thakur-sachin/walking_trex_project/docs/ABLATION_STUDY.md

# Ablation study

Every training run of the Trex walking task: what it changed, why, what was measured and what was learned.
Generated by `walk_rl/ablation_study.py` from `walk_rl/experiments/registry.yaml` and `outputs/walk_runs/` (2026-10-24 10:53). Do not edit by hand.

**How to read it.** Each run makes one change against its parent. Results are only comparable within one robot model: the simulator's robot changed six times as measurements came in. A value marked † was measured on a later model than the run trained on (the file was re-run after a model change). Each run is judged on the servo model it trained with: `ideal` is the PD drive of M0/M1, `lx16a` the fitted LX-16A model. Isaac numbers are walking at 0.10 m/s with randomization on; MuJoCo numbers are the deployed NumPy loop over friction × bus delay (median speed). "MuJoCo own model" is the same sweep with the robot rebuilt from the robot_config the run trained with, so every run is scored on its own robot; it shows transfer to a second engine, not a ranking across models. Old run configs: `git show <config>`.

## Robot models

| model | from | change | detail |
|---|---|---|---|
| M0 | 2026-10-09 00:00 | URDF model, ideal servo | torso inertia from the URDF (a steel shell), PD position drive at datasheet speed, CAD masses (1.78 kg) |
| M1 | 2026-10-15 20:55 | corrected torso and ankle | composite torso inertia (~5x below the URDF), ankle torque routed through the linkage |
| M2 | 2026-10-18 17:19 | + LX-16A servo model (unloaded fit) | explicit torque model fitted to single-servo moves in the air; ~4x slower than M0's servo |
| M3 | 2026-10-19 15:22 | + as-built joint ranges, mass estimates | hips -30..+7 deg, tibia -45..+90 deg, coupled ankle limit; 1.50 kg |
| M4 | 2026-10-19 21:54 | + measured masses | whole robot 1.307 kg weighed; torso inertia from its parts |
| M5 | 2026-10-20 22:44 | + servo model refit to real walks | kp, friction, speed and stall refit by replaying the real v9m walks in MuJoCo |
| M6 | 2026-10-21 22:50 | + measured centre of mass | battery and electronics moved 25 mm back so the whole-robot CoM sits 30 mm ahead of the heel edge (measured balance point; was 40.8 mm) |
| M7 | 2026-10-23 21:40 | + joint limits v2 | joint stops measured by hand: head -45..+35, tail +-45, hips -45..+7, femurs +-50, tibias -35..+75 deg (v1: +-45, hips -30..+7, tibias -45..+90) |

## Runs

| run | parent | model | servo | change | Isaac speed @0.10 | Isaac hard surv. | MuJoCo survived | MuJoCo speed @0.10 | MuJoCo own model: survived | own model: speed @0.10 | scorecard | real robot | verdict |
|---|---|---|---|---|---|---|---|---|---|---|---|---|---|
| **v1** |  | M0 | ideal | first walking task; adaptive learning rate | — | — | — | — | — | — | — | — | rejected |
| **v2** | v1 | M0 | ideal | + yaw tracking, action_accel -0.5 | — | — | — | — | — | — | — | — | rejected |
| **v3** | v2 | M0 | ideal | command low-pass, action_accel -0.05, LR 1e-3 | — | — | — | — | — | — | — | — | rejected |
| **v4** | v3 | M0 | ideal | KL guard, best checkpoints, from scratch | — | — | — | — | — | — | — | — | rejected |
| **v6** | v4 | M0 | ideal | any non-foot ground contact ends the episode; contact from forces | — | — | — | — | — | — | — | — | rejected |
| **v7** | v6 | M0 | ideal | training-only harness (70 % body weight + righting torque, gone by iteration 450); stale-contact fix | 90% | 0.35 | — | — | 25/36 | 54% | — | — | base |
| **v8c** | v7 | M0 | ideal | heading observation, 3-frame history, delays, encoder offsets, pushes, new rewards | 97% | 0.88 | — | — | 33/36 | 61% | — | — | superseded |
| **v8b** | v8c | M0 | ideal | v8c without pushes | 101% | 0.95 | — | — | 13/36 | 56% | — | — | rejected |
| **v8d** | v8c | M0 | ideal | gait clock frequency scales with speed | 90% | 0.91 | 50/54 | 68% | 33/36 | 62% | — | — | base |
| **v8e** | v8d | M0 | ideal | 16384 envs, 3000 iterations, pushes to 0.35 m/s | 94% | 0.98 | — | — | 32/36 | 77% | — | — | superseded |
| **v8e_lab** | v8e | M0 | ideal | the same config on the Isaac Lab port | 90% | 0.98 | — | — | 23/36 | 36% | — | — | superseded |
| **v8e_lab_rsl** | v8e | M0 | ideal | rsl_rl PPO instead of the in-repo PPO | — | — | — | — | — | — | — | — | aborted |
| **v9p** | v8e | M1 | ideal | corrected robot model, torso-inertia and wood-friction randomization, std cap 0.5 | 106% | 0.98 | 24/27 | 66% | 31/36 | 66% | — | — | superseded |
| **v9a** | v9p | M1 | ideal | + lateral_drift, roll_band, foot_flat | 113% | 0.99 | 20/27 | 66% | 23/36 | 66% | — | — | base |
| **v9b** | v9a | M1 | ideal | + mirror augmentation | 128% | 0.82 | 18/27 | 88% | 23/36 | 88% | — | — | rejected |
| **v9c** | v9a | M2 | lx16a | + actuator.model lx16a | 13%† | 0.7† | 32/36† | 0%† | 36/36 | 0% | 3/11 | — | superseded |
| **v9d** | v9c | M2 | lx16a | track_vx sigma relative to the command, both-feet gait contact, slow-command oversampling | 53%† | 0.75† | 32/36† | 15%† | 36/36 | 37% | — | — | superseded |
| **v9e** | v9d | M3 | lx16a | tibia action scale 90 deg | 2% | 0.96 | 34/36 | 0% | 34/36 | 0% | — | — | rejected |
| **v9f** | v9d | M3 | lx16a | tibia +-67.5 deg about +22.5 deg (shifted action centre) | 0% | 0.99 | 36/36 | 0% | 36/36 | 0% | — | — | rejected |
| **v9g** | v9d | M4 | lx16a | none (v9d recipe on the measured robot) | — | — | — | — | 36/36 | 0% | — | — | rejected |
| **v9h** | v9g | M4 | lx16a | reward.progress_gate (posture and smoothness rewards scale with v_x / cmd) | 129% | 0.95 | 21/36 | 56% | 21/36 | 56% | — | — | superseded |
| **v9i** | v9h | M4 | lx16a | progress_gate_mode tracking (gate peaks at the command) | 86% | 0.95 | 32/36 | 59% | 32/36 | 59% | 3/11 | — | superseded |
| **v9j** | v9i | M4 | lx16a | + leg_symmetry (1 s mean of left - right femur/tibia), weak base_height | 87% | 0.9 | 32/36 | 57% | 32/36 | 57% | 5/11 | — | superseded |
| **v9k** | v9j | M4 | lx16a | + joint_pose on head and tail | 84% | 0.92 | 33/36 | 43% | 33/36 | 43% | 5/11 | — | superseded |
| **v9l** | v9k | M4 | lx16a | foot_slip at the sole centre, weight -100 | 0% | 0.86 | 34/36 | 0% | 34/36 | 0% | 1/11 | — | rejected |
| **v9m** | v9k | M4 | lx16a | foot_slip at the sole centre, weight -10 | 88% | 0.96 | 29/36† | 52%† | 33/36 | 59% | 7/11 | 2026-10-20 floor, 0.10 m/s for 10 s: 0.41 m (41 %), no fall, yaw +7 deg | deployed |
| **v9n** | v9m | M5 | lx16a | servo model refit to the real walks (randomization re-centred) + IMU mount offset +-2 deg | 94% | 0.95 | 33/36 | 72% | 33/36 | 72% | 6/11 | 2026-10-21 floor, 0.10 m/s for 10 s: 0.25 m (25 %), turned +49 deg; head -14, tail +18, hips +3 / -9 deg mean | deployed |
| **v9o** | v9n | M5 | lx16a | + mirror loss 0.5 (soft left/right symmetry) | 91% | 0.97 | 35/36 | 70% | 35/36 | 70% | 6/11 | 2026-10-21 floor, 0.10 m/s for 10 s: 0.46 m (46 %), yaw -8 deg, slight drift right, no crab; head -1, tail -2, hips -7 / -3 deg mean | deployed |
| **v9q** | v9o | M6 | lx16a | training friction down to the measured floor (0.12-0.85 effective via ground friction 0.1; was 0.30-0.85) | 89% | 0.91 | 36/36 | 77% | 36/36 | 77% | 6/11 | — | candidate |
| **v9r** | v9o | M6 | lx16a | none (v9o recipe retrained on M6); control run for v9q | 90% | 0.88 | 36/36 | 78% | 36/36 | 78% | 6/11 | — | rejected |
| **v9s** | v9q | M6 | lx16a | + joint-limit penalty over the last 3 deg of the physical range (reward.joint_limit_range_margin_deg 3) | 90% | 0.78 | 36/36 | 105% | 36/36 | 105% | 8/11 | 2026-10-22 wood floor, 0.10 m/s for 10 s: 0.36 m (36 %), yaw -1 deg net (+6 deg on a first run without video); hips -2 / -2 deg, head +6, tail +3 deg; joint swing 2-3 deg. Carpet, same schedule: > 0.70 m (> 70 %), yaw +54 / +15 deg (two runs), left hip ~2 deg more inward | deployed |
| **v9t** | v9s | M6 | lx16a | swing_clearance reward weight 2 -> 8 (foot lift) | 84% | 0.89 | 36/36 | 100% | 36/36 | 100% | 8/11 | 2026-10-23 wood floor, 0.10 m/s for 10 s: barely moved forward, turned on the spot +78 deg left (log yaw); +37 deg in the first 2 s, while it goes from the standing pose (tibias +45, femurs +10 deg) to the walking crouch (femurs -26, tibias -10 to -13 deg), then +40 deg over 9 s; joint swing 5-7 deg (v9s 2-3), roll -2..+6 deg, no fall. Carpet, same schedule (after two USB-adapter resets, nothing moved): joint swing 8-11 deg, roll -17..+7 deg, yaw +64 deg by the stop; fell 0.7 s after the command went to 0 (head swung to +41 deg, tilt 55 deg forward-left, safety stop). Carpet run 2 (2026-10-23, no fall): ~0.70 m forward and ~0.40 m to the left (0.81 m straight line), yaw about +34 deg net, roll -12..+14 deg, joint swing 7-12 deg. Wood run 2 (2026-10-23): ~0.50 m forward (50 %, the best wood result; v9o 46 %) and ~0.20 m to the right, then it hit a wall on its right; yaw at most -17 deg, +4 deg net; roll +2..+8 deg; joint swing 4-8 deg; no fall. Wood runs 3-5 (2026-10-23): turned > 100 deg left at some point in every run (+88 / +74 / +65 deg net), distances not measured | rejected |
| **v9u** | v9s | M7 | lx16a | none (v9s recipe retrained on M7, joint limits v2) | — | — | — | — | — | — | — | — | aborted |
| **v9v** | v9s | M7 | lx16a | actions.scale_to_range (action mapped onto the physical range of joint limits v2, no range clip) | 88% | 0.82 | 36/36 | 86% | 36/36 | 86% | 8/11 | — | candidate |
| **v9w** | v9v | M7 | lx16a | reward joint_speed -2.0 = relu(weighted mean |joint vel| - 0.7 rad/s), tail weight 2 | 76% | 0.81 | 36/36 | 71% | — | — | 8/11 | — | candidate (sim speed target missed) |

## Run details

### v1 · M0 · rejected

- **Change:** first walking task; adaptive learning rate
- **Why:** baseline of the new task
- **Result:** circled 100-116 deg per 20 s and chattered while standing; later found to lean on its tail
- **Lesson:** an adaptive (rsl_rl-style) LR pins at its floor when the action std is small
- **Training:** 404 iterations, 4096 envs, 30 min, final action std 0.13

### v2 ← v1 · M0 · rejected

- **Change:** + yaw tracking, action_accel -0.5
- **Why:** stop the circling and the chatter
- **Result:** never learned; the penalty charged ~-3 per step for exploration noise
- **Lesson:** smoothness penalties on sampled actions punish exploration; use a command low-pass instead

### v3 ← v2 · M0 · rejected

- **Change:** command low-pass, action_accel -0.05, LR 1e-3
- **Why:** structural smoothing instead of a heavy penalty
- **Result:** best curve to iteration ~750, then collapsed in one update (KL 0.24 at std 0.13); best weights lost
- **Lesson:** keep a per-minibatch KL guard, best.pt and periodic checkpoints
- **Training:** 800 iterations, 4096 envs, 79 min, final action std 0.13

### v4 ← v3 · M0 · rejected

- **Change:** KL guard, best checkpoints, from scratch
- **Why:** v3's recipe without the collapse
- **Result:** 100 % survival and ~97 % tracking, but it walked on a tripod (tail on the ground); 0 % survival once that is a fall
- **Lesson:** make every implied rule an explicit termination; look at the frames before believing a metric
- **Training:** 900 iterations, 4096 envs, 74 min, final action std 0.14

### v6 ← v4 · M0 · rejected

- **Change:** any non-foot ground contact ends the episode; contact from forces
- **Why:** only the feet may touch the ground
- **Result:** stood still (foot air time 0.000 at iteration 200)
- **Lesson:** lifting a foot unaided is an exploration barrier

### v7 ← v6 · M0 · base

- **Change:** training-only harness (70 % body weight + righting torque, gone by iteration 450); stale-contact fix
- **Why:** get past the exploration barrier
- **Result:** first valid biped; 99 % survival at 0.10, 97 % tracking; heading drift up to 34 deg per 20 s
- **Lesson:** a curriculum that is removed during training can open a gait that RL does not find alone
- **Training:** 1000 iterations, 4096 envs, 51 min, final action std 0.26

### v8c ← v7 · M0 · superseded

- **Change:** heading observation, 3-frame history, delays, encoder offsets, pushes, new rewards
- **Why:** robustness to the real sensors and drift
- **Result:** heading change 0.7-2.4 deg per 20 s (v7 10-34); hard-sensor survival 88-97 % (v7 35-58 %)
- **Training:** 1000 iterations, 4096 envs, 66 min, final action std 0.28

### v8b ← v8c · M0 · rejected

- **Change:** v8c without pushes
- **Why:** which part of v8 did the work
- **Result:** best speed and hard-sensor survival; push survival 0.88 vs 0.95
- **Lesson:** observations, rewards and sensor delays did the heavy lifting; pushes buy push recovery only
- **Training:** 1000 iterations, 4096 envs, 88 min, final action std 0.26
- **Config:** `git show 1017f24:walk_rl/experiments/v8b_no_robustness.yaml`

### v8d ← v8c · M0 · base

- **Change:** gait clock frequency scales with speed
- **Why:** less sway at speed, less standing jitter
- **Result:** standing jitter halved; speed still capped at ~0.15-0.17 m/s (tibias on their 45 deg limit)
- **Lesson:** when every reward variant hits the same ceiling, check joint limits first
- **Training:** 1000 iterations, 4096 envs, 93 min, final action std 0.28
- **Config:** `git show 1017f24:walk_rl/experiments/v8d_gait_freq.yaml`

### v8e ← v8d · M0 · superseded

- **Change:** 16384 envs, 3000 iterations, pushes to 0.35 m/s
- **Why:** scale
- **Result:** survival 0.98-1.00, but action std ran away to 3.9
- **Lesson:** cap the action std (ppo.max_action_std 0.5)
- **Training:** 3000 iterations, 16384 envs, 523 min, final action std 3.89
- **Config:** `git show ca6f384:walk_rl/experiments/v8e_long_16k.yaml`

### v8e_lab ← v8e · M0 · superseded

- **Change:** the same config on the Isaac Lab port
- **Why:** platform comparison
- **Result:** evaluated on Isaac Sim 0.98-1.00, so training is at parity; std ran away to 34.6
- **Lesson:** same config and seed train different policies on the two stacks; compare statistically
- **Stack:** isaaclab
- **Training:** 3000 iterations, 16384 envs, 513 min, final action std 34.64

### v8e_lab_rsl ← v8e · M0 · aborted

- **Change:** rsl_rl PPO instead of the in-repo PPO
- **Why:** trainer comparison
- **Result:** stopped at iteration 2475 of 3000 when the GPU went to v9; never evaluated
- **Stack:** isaaclab + rsl_rl
- **Training:** 2475 iterations, 16384 envs, 453 min, final action std 0

### v9p ← v8e · M1 · superseded

- **Change:** corrected robot model, torso-inertia and wood-friction randomization, std cap 0.5
- **Why:** physics baseline for every v9 ablation
- **Result:** hard survival 0.98; sideways drift 1.13 m per 20 s at 0.20
- **Training:** 1500 iterations, 4096 envs, 80 min, final action std 0.32
- **Config:** `git show 0047918:walk_rl/experiments/v9p_physics.yaml`

### v9a ← v9p · M1 · base

- **Change:** + lateral_drift, roll_band, foot_flat
- **Why:** v8d crabs ~1 m per 20 s to +y
- **Result:** drift 0.26 m per 20 s (v9p 1.13), roll 15 deg; MuJoCo 7 falls of 27
- **Training:** 1500 iterations, 4096 envs, 81 min, final action std 0.31
- **Config:** `git show 7fbf07e:walk_rl/experiments/v9a_lateral.yaml`

### v9b ← v9a · M1 · rejected

- **Change:** + mirror augmentation
- **Why:** the limp behind the crab is learned (CAD symmetric to 3 mm)
- **Result:** even gait, drift 0.17 m, but hard survival 0.82 and 8 deg yaw while standing
- **Lesson:** hard mirror augmentation costs robustness
- **Training:** 1500 iterations, 4096 envs, 80 min, final action std 0.35
- **Config:** `git show 0047918:walk_rl/experiments/v9b_symmetry.yaml`

### v9c ← v9a · M2 · superseded

- **Change:** + actuator.model lx16a
- **Why:** no earlier policy walks on the fitted servo (walking survival 0.02-0.46)
- **Result:** walking survival 0.99-1.00 on the fitted servo, MuJoCo 27/27; stands below ~0.12 m/s
- **Lesson:** measure the hardware early; the 4x slower servo invalidated every earlier policy
- **Training:** 1500 iterations, 4096 envs, 83 min, final action std 0.26
- **Scorecard:** 3/11; fails: MuJoCo survival, MuJoCo speed @0.10, Isaac speed 0.05-0.15, worst joint at limit, foot lift min @0.10, side / forward @0.10, Isaac saturation max, Isaac hard survival min
- **Config:** `git show 4520314:walk_rl/experiments/v9c_actuator.yaml`

### v9d ← v9c · M2 · superseded

- **Change:** track_vx sigma relative to the command, both-feet gait contact, slow-command oversampling
- **Why:** standing earned ~50 % of track_vx at 0.05 m/s
- **Result:** 99 % of 0.10 in Isaac, MuJoCo 36/36; still stands below ~0.08
- **Lesson:** a fixed tracking kernel lets standing win at slow commands
- **Training:** 1500 iterations, 4096 envs, 90 min, final action std 0.24
- **Config:** `git show d05b2e2:walk_rl/experiments/v9d_slow_gait.yaml`

### v9e ← v9d · M3 · rejected

- **Change:** tibia action scale 90 deg
- **Why:** reach the forward-knee range
- **Result:** walks only from 0.15 m/s; push survival 0.69 (v9d 0.84)
- **Lesson:** a wider action scale doubles exploration noise and halves resolution
- **Training:** 1500 iterations, 4096 envs, 83 min, final action std 0.39
- **Config:** `git show 8c2e1cb:walk_rl/experiments/v9e_knee_range.yaml`

### v9f ← v9d · M3 · rejected

- **Change:** tibia +-67.5 deg about +22.5 deg (shifted action centre)
- **Why:** the knee range without v9e's resolution loss
- **Result:** stands at every command
- **Training:** 1500 iterations, 4096 envs, 85 min, final action std 0.37
- **Config:** `git show b69185e:walk_rl/experiments/v9f_knee_shift.yaml`

### v9g ← v9d · M4 · rejected

- **Change:** none (v9d recipe on the measured robot)
- **Why:** control for v9f
- **Result:** drifted to standing once pushes started (~iteration 500); stopped at 908
- **Lesson:** the standing trap - heading and yaw rewards pay standing almost as much as walking
- **Training:** 908 iterations, 4096 envs, 58 min, final action std 0.26
- **Config:** `git show af2091b:walk_rl/experiments/v9g_control.yaml`

### v9h ← v9g · M4 · superseded

- **Change:** reward.progress_gate (posture and smoothness rewards scale with v_x / cmd)
- **Why:** break the standing trap
- **Result:** walks again, but at 0.10-0.16 m/s whatever the command; MuJoCo 21/36
- **Training:** 1500 iterations, 4096 envs, 82 min, final action std 0.24
- **Config:** `git show fde54b2:walk_rl/experiments/v9h_progress_gate.yaml`

### v9i ← v9h · M4 · superseded

- **Change:** progress_gate_mode tracking (gate peaks at the command)
- **Why:** v9h ignored the command
- **Result:** tracks 0.05-0.15 at 85-93 %; MuJoCo 32/36; video worse than v9c/v9d (scoots, left foot steps back)
- **Lesson:** Isaac-only metrics can hide a scoot; add a gait scorecard
- **Training:** 1500 iterations, 4096 envs, 139 min, final action std 0.3
- **Scorecard:** 3/11; fails: MuJoCo survival, MuJoCo speed @0.10, femur / tibia L-R, worst joint at limit, foot lift min @0.10, side / forward @0.10, Isaac step L/R @0.10,0.15, Isaac saturation max
- **Config:** `git show 7e2670e:walk_rl/experiments/v9i_tracking_gate.yaml`

### v9j ← v9i · M4 · superseded

- **Change:** + leg_symmetry (1 s mean of left - right femur/tibia), weak base_height
- **Why:** tibias 61 deg apart in v9i
- **Targets:** femur / tibia L-R <= 10 deg
- **Result:** legs symmetric (-1 / +4 deg), drift 9 % of forward distance (v9i 142 %)
- **Training:** 1500 iterations, 4096 envs, 90 min, final action std 0.21
- **Scorecard:** 5/11; fails: MuJoCo survival, MuJoCo speed @0.10, worst joint at limit, Isaac step L/R @0.10,0.15, Isaac saturation max, Isaac hard survival min
- **Config:** `git show e09617f:walk_rl/experiments/v9j_posture.yaml`

### v9k ← v9j · M4 · superseded

- **Change:** + joint_pose on head and tail
- **Why:** head and tail pinned at a range end move the CoM < 2 mm and caused falls
- **Result:** head/tail near neutral, steps 1.1 / 1.1 cm; MuJoCo speed 43 % of 0.10
- **Training:** 1500 iterations, 4096 envs, 84 min, final action std 0.15
- **Scorecard:** 5/11; fails: MuJoCo survival, MuJoCo speed @0.10, Isaac speed 0.05-0.15, foot lift min @0.10, Isaac saturation max, Isaac hard survival min
- **Config:** `git show 0053568:walk_rl/experiments/v9k_head_tail.yaml`

### v9l ← v9k · M4 · rejected

- **Change:** foot_slip at the sole centre, weight -100
- **Why:** replay showed ~60 % of Isaac progress was the soles skating
- **Result:** learned to stand
- **Lesson:** a penalty as large as half the reward makes standing the optimum; size weights against the per-step reward
- **Training:** 1500 iterations, 4096 envs, 86 min, final action std 0.18
- **Scorecard:** 1/11; fails: MuJoCo survival, MuJoCo speed @0.10, Isaac speed 0.05-0.15, femur / tibia L-R, worst joint at limit, foot lift min @0.10, side / forward @0.10, Isaac step L/R @0.10,0.15, Isaac saturation max, Isaac hard survival min
- **Config:** `git show 5d470ff:walk_rl/experiments/v9l_sole_slip.yaml`

### v9m ← v9k · M4 · deployed

- **Change:** foot_slip at the sole centre, weight -10
- **Why:** same as v9l at a size that keeps walking cheaper than standing
- **Result:** sole slide 140 mm (v9k 541); Isaac 88 % of 0.10, MuJoCo 52-59 %
- **Real robot:** 2026-10-20 floor, 0.10 m/s for 10 s: 0.41 m (41 %), no fall, yaw +7 deg
- **Lesson:** the real robot made 41 % where Isaac said 88 % and MuJoCo 52-59 %
- **Training:** 1500 iterations, 4096 envs, 85 min, final action std 0.14
- **Scorecard:** 7/11; fails: MuJoCo survival, MuJoCo speed @0.10, Isaac step L/R @0.10,0.15, Isaac saturation max
- **Config:** `git show 3a021e3:walk_rl/experiments/v9m_slip10.yaml`

### v9n ← v9m · M5 · deployed

- **Change:** servo model refit to the real walks (randomization re-centred) + IMU mount offset +-2 deg
- **Why:** real servos held their goals within 0.5 deg where both sims gave 2-5 deg; 1-3 deg attitude offsets swung v9m between 0 and 0.08 m/s
- **Targets:** MuJoCo speed >= 70 % of 0.10; speed stable under 1-3 deg IMU offsets
- **Result:** MuJoCo 72 %, stable under IMU offsets; left hip at its range end 55 %, steps 0.4 / 2.7 cm
- **Real robot:** 2026-10-21 floor, 0.10 m/s for 10 s: 0.25 m (25 %), turned +49 deg; head -14, tail +18, hips +3 / -9 deg mean
- **Lesson:** a one-sided posture that only drifts 5 deg in MuJoCo turned 49 deg on the real floor
- **Training:** 1500 iterations, 4096 envs, 86 min, final action std 0.15
- **Scorecard:** 6/11; fails: MuJoCo survival, worst joint at limit, foot lift min @0.10, Isaac step L/R @0.10,0.15, Isaac hard survival min
- **Config:** `git show f20acf4:walk_rl/experiments/v9n_servo_refit.yaml`

### v9o ← v9n · M5 · deployed

- **Change:** + mirror loss 0.5 (soft left/right symmetry)
- **Why:** the real v9n turn came from a learned one-sided posture, also visible in MuJoCo and Isaac
- **Targets:** head/tail mean within +-5 deg; left hip at its end <= 20 %; Isaac steps within 2x; keep MuJoCo >= 70 % and IMU-offset robustness
- **Result:** head/tail -1 / -1 deg, no joint at a range end, MuJoCo heading change -0.2 deg, MuJoCo 70 %; steps 1.6 / 0.8 cm (2.0x); drifts sideways 43 % of forward distance in MuJoCo
- **Real robot:** 2026-10-21 floor, 0.10 m/s for 10 s: 0.46 m (46 %), yaw -8 deg, slight drift right, no crab; head -1, tail -2, hips -7 / -3 deg mean
- **Lesson:** the soft mirror loss removed the real turn and gave the best real speed so far; the MuJoCo sideways drift did not transfer
- **Training:** 1500 iterations, 4096 envs, 88 min, final action std 0.14
- **Scorecard:** 6/11; fails: MuJoCo survival, MuJoCo speed @0.10, foot lift min @0.10, side / forward @0.10, Isaac step L/R @0.10,0.15
- **Config:** `git show 92b3140:walk_rl/experiments/v9o_mirror_loss.yaml`

### v9q ← v9o · M6 · candidate

- **Change:** training friction down to the measured floor (0.12-0.85 effective via ground friction 0.1; was 0.30-0.85)
- **Why:** real wood is static mu 0.27 (tilt test), below the training range; on M6 v9o makes 34 / 67 / 75 % of 0.10 in MuJoCo at mu 0.15 / 0.20 / 0.27
- **Targets:** MuJoCo >= 60 % of 0.10 at mu 0.15, 0.20, 0.27; MuJoCo survival >= 35/36 and no fall at mu 0.15; head/tail mean within +-5 deg, no joint at a range end > 20 %; real floor >= 50 %
- **Result:** MuJoCo 80-91 / 82-91 / 81-84 % of 0.10 at mu 0.15 / 0.20 / 0.27, 36/36 at low mu; head/tail -1 / +5 deg; right hip at its +7 deg inward end 49-51 % while walking (hips -8 / +2 deg); Isaac 46 % at 0.05, hard survival 0.91; side drift 15 %
- **Lesson:** the low-friction training range fixed the MuJoCo low-friction speed, but on M6 the policy rides the hip goal clip; the joint-limit penalty only sees the symmetric +-30 deg limit, not the +7 deg inward range end
- **Training:** 1500 iterations, 4096 envs, 148 min, final action std 0.15
- **Scorecard:** 6/11; fails: Isaac speed 0.05-0.15, worst joint at limit, foot lift min @0.10, Isaac step L/R @0.10,0.15, Isaac hard survival min
- **Config:** `git show 54f8efb:walk_rl/experiments/v9q_low_friction.yaml`

### v9r ← v9o · M6 · rejected

- **Change:** none (v9o recipe retrained on M6); control run for v9q
- **Why:** v9q changes the robot model and the training friction together; v9r isolates the model change
- **Targets:** same as v9q; hypothesis - keeps v9o's weakness at mu 0.15
- **Result:** MuJoCo 68-144 % of 0.10 at mu 0.15-0.27 (overspeed), 36/36; stands with both hips at +6 deg (inward end 100 %), does not walk at 0.05 (1 %, tail +25 deg); roll spread 22 deg; Isaac hard survival 0.88
- **Lesson:** hypothesis false - M6 alone does not keep v9o's low-friction weakness, but the v9o recipe on M6 parks both hips on the inward goal clip and stops walking at 0.05; M6 needs a range-aware limit penalty
- **Training:** 1500 iterations, 4096 envs, 149 min, final action std 0.19
- **Scorecard:** 6/11; fails: Isaac speed 0.05-0.15, worst joint at limit, roll spread @0.10, Isaac step L/R @0.10,0.15, Isaac hard survival min
- **Config:** `git show 147ced1:walk_rl/experiments/v9r_m6_control.yaml`

### v9s ← v9q · M6 · deployed

- **Change:** + joint-limit penalty over the last 3 deg of the physical range (reward.joint_limit_range_margin_deg 3)
- **Why:** on M6 v9q kept its right hip on the +7 deg inward goal clip 49-51 % of the walk and v9r parked both hips there; the symmetric +-30 deg penalty did not see that end
- **Targets:** no joint at a range end > 20 %; hips mean within +-5 deg, left - right within 4 deg; keep MuJoCo >= 60 % of 0.10 at mu 0.15 / 0.20 / 0.27 and survival >= 35/36; Isaac >= 60 % at 0.05; real floor >= 50 %
- **Result:** no joint at a range end (hips <= 3 %), hips -2 / -2 deg, heading change 0 deg in the video; MuJoCo 61-71 / 56-66 / 81-87 % of 0.10 at mu 0.15 / 0.20 / 0.27, 36/36; Isaac 99 / 90 / 82 % at 0.05 / 0.10 / 0.15; head +15 deg while standing (+6 walking); Isaac hard survival 0.78 at 0.25 (0.95 at 0.10); scorecard 8/10
- **Real robot:** 2026-10-22 wood floor, 0.10 m/s for 10 s: 0.36 m (36 %), yaw -1 deg net (+6 deg on a first run without video); hips -2 / -2 deg, head +6, tail +3 deg; joint swing 2-3 deg. Carpet, same schedule: > 0.70 m (> 70 %), yaw +54 / +15 deg (two runs), left hip ~2 deg more inward
- **Lesson:** the best sim scorecard gave a worse real walk than v9o; the hip fix transferred (posture as in MuJoCo), but v9s shuffles - joint swing 2-3 deg and foot lift 5.8 mm (v9o 5-8 deg, 14-16 mm) - so its sim speed relied on contact effects the floor does not give; on carpet the same policy made > 70 %, so the wood loss is foot slip, not the gait command; add a foot-lift target to the scorecard
- **Training:** 1500 iterations, 4096 envs, 85 min, final action std 0.13
- **Scorecard:** 8/11; fails: foot lift min @0.10, Isaac step L/R @0.10,0.15, Isaac hard survival min
- **Config:** `git show 7eb3a57:walk_rl/experiments/v9s_range_limit.yaml`

### v9t ← v9s · M6 · rejected

- **Change:** swing_clearance reward weight 2 -> 8 (foot lift)
- **Why:** v9s shuffled (foot lift 6 mm, joint swing 2-3 deg) and made 36 % on wood but > 70 % on carpet; its clearance reward fell to a quarter of v9o's
- **Targets:** MuJoCo foot lift >= 12 mm each foot; femur and tibia swing >= 4 deg; keep no joint at a range end > 20 %, hips within +-5 deg, MuJoCo >= 60 % of 0.10 at mu 0.15 / 0.20 / 0.27, survival >= 35/36, Isaac >= 60 % at 0.05; real wood >= 50 %
- **Result:** foot lift 39 mm, joint swing hips 8 / femurs 10 / tibias 12 deg std (v9s 2-3) - a stepping gait; MuJoCo 36/36, 100 % of 0.10 (home model 119 / 91 / 59 % at 0.05 / 0.10 / 0.20), 58-65 / 55-72 / 58-77 % of 0.10 at mu 0.15 / 0.20 / 0.27 (target 60: two of nine conditions miss); hips -6 / -6 deg (target +-5: miss); tibias at the -45 deg end 17 % median, 33 % worst episode; roll spread 19 deg (v9s 5); Isaac 95 / 84 / 70 % at 0.05 / 0.10 / 0.15, hard survival 0.89; head -22 to -35 deg while walking; scorecard 8/11
- **Real robot:** 2026-10-23 wood floor, 0.10 m/s for 10 s: barely moved forward, turned on the spot +78 deg left (log yaw); +37 deg in the first 2 s, while it goes from the standing pose (tibias +45, femurs +10 deg) to the walking crouch (femurs -26, tibias -10 to -13 deg), then +40 deg over 9 s; joint swing 5-7 deg (v9s 2-3), roll -2..+6 deg, no fall. Carpet, same schedule (after two USB-adapter resets, nothing moved): joint swing 8-11 deg, roll -17..+7 deg, yaw +64 deg by the stop; fell 0.7 s after the command went to 0 (head swung to +41 deg, tilt 55 deg forward-left, safety stop). Carpet run 2 (2026-10-23, no fall): ~0.70 m forward and ~0.40 m to the left (0.81 m straight line), yaw about +34 deg net, roll -12..+14 deg, joint swing 7-12 deg. Wood run 2 (2026-10-23): ~0.50 m forward (50 %, the best wood result; v9o 46 %) and ~0.20 m to the right, then it hit a wall on its right; yaw at most -17 deg, +4 deg net; roll +2..+8 deg; joint swing 4-8 deg; no fall. Wood runs 3-5 (2026-10-23): turned > 100 deg left at some point in every run (+88 / +74 / +65 deg net), distances not measured
- **Lesson:** wood results vary run to run (0 m with a 78 deg turn, then 0.50 m nearly straight), so one floor run is not enough to judge a policy; carpet ~70 % forward, as v9s, but 40 cm to the left; a high-lift crouched gait on a slippery floor pivots instead of walking; the 55 deg stand-to-walk posture change twists the robot at the start
- **Training:** 1500 iterations, 4096 envs, 85 min, final action std 0.15
- **Scorecard:** 8/11; fails: Isaac speed 0.05-0.15, roll spread @0.10, Isaac hard survival min
- **Config:** `git show 22baef8:walk_rl/experiments/v9t_foot_lift.yaml`

### v9u ← v9s · M7 · aborted

- **Change:** none (v9s recipe retrained on M7, joint limits v2)
- **Why:** the sim joint ranges were CAD estimates; the hand-measured stops differ (head +35, tibias -35..+75, femurs +-50, hips -45..+7); v9t sat on the sim tibia -45 end, 10 deg past the real stop
- **Targets:** MuJoCo survival >= 35/36, >= 90 % of 0.10, >= 60 % of 0.10 at mu 0.15 / 0.20 / 0.27; no joint at a range end > 20 %; hips mean within +-5 deg; scorecard >= 8/11; real wood >= 36 % with |yaw| <= 25 deg in every run, carpet >= 70 %
- **Result:** stopped after 7 min (iteration ~130); with the +-45 / hips +-30 action scale the policy could not reach the v2 limits and its goals were still clipped to the range; replaced by v9v
- **Training:** 109 iterations, 4096 envs, 6 min, final action std 0.26
- **Config:** `git show 6bb7d71:walk_rl/experiments/v9u_limits_v2.yaml`

### v9v ← v9s · M7 · candidate

- **Change:** actions.scale_to_range (action mapped onto the physical range of joint limits v2, no range clip)
- **Why:** Sachin - what the policy learns is the goal sent to the robot; with the +-45 scale v9u could not reach the v2 limits (femurs +-50, tibias +75, hips -45) and was clipped at head +35 and tibias -35
- **Targets:** MuJoCo survival >= 35/36, >= 90 % of 0.10, >= 60 % of 0.10 at mu 0.15 / 0.20 / 0.27; no joint at a range end > 20 %; hips mean within +-5 deg; scorecard >= 8/11; real wood >= 36 % with |yaw| <= 25 deg in every run, carpet >= 70 %
- **Result:** sim - MuJoCo 36/36, 86 % of 0.10 (target 90 %, missed; home model 84 %), 68 / 69 / 76 % of 0.10 at mu 0.15 / 0.20 / 0.27 (v9s 66 / 62 / 84), no fall; worst joint at a range end right hip 1 %; hips mean -4.7 / -4.2 deg; foot lift min 10 mm (v9s 6, v9t 39); roll spread 8 deg; scorecard 8/11; mean tibia L/R +7 / 0 deg at mu 0.27; real robot not tested yet
- **Training:** 1500 iterations, 4096 envs, 84 min, final action std 0.14
- **Scorecard:** 8/11; fails: Isaac speed 0.05-0.15, foot lift min @0.10, Isaac hard survival min
- **Config:** `git show 464bdf5:walk_rl/experiments/v9v_full_range.yaml`

### v9w ← v9v · M7 · candidate (sim speed target missed)

- **Change:** reward joint_speed -2.0 = relu(weighted mean |joint vel| - 0.7 rad/s), tail weight 2
- **Why:** v9v reset the USB servo adapter twice on wood (8 s, 11 s); hanging it sagged the servo supply to 4.97 V (v9s 6.01 V) at 88 deg/s mean joint speed (v9s 48), tail swing 54 deg (v9s 14); MuJoCo agrees (81 deg/s, tail 136 deg/s; v9s 43 / 20)
- **Targets:** MuJoCo mean joint speed <= 50 deg/s and tail <= 40 deg/s at 0.10 / mu 0.3; MuJoCo survival >= 35/36, >= 90 % of 0.10, >= 60 % of 0.10 at mu 0.15 / 0.20 / 0.27; no joint at a range end > 20 %; hips mean within +-5 deg; scorecard >= 8/11; hanging lowest servo supply >= 6.0 V; real wood no adapter reset, >= 36 % with |yaw| <= 25 deg every run; carpet >= 70 %
- **Result:** sim - MuJoCo 36/36, 71 % of 0.10 (target 90 %, missed; v9v 86 %, v9s 105 %), 79 / 77 / 74 % at mu 0.15 / 0.20 / 0.27, no fall; mean joint speed 31-35 deg/s (target <= 50; v9v 81), tail 2-6 deg/s (target <= 40; v9v 136); worst joint at a range end head 0 %; hips mean -4.6 / -4.7 deg (-5.2 at mu 0.15); foot lift min 11 mm; Isaac saturation 0.1 %; scorecard 8/11; the speed cost traded forward speed (the stated risk); real robot not tested yet. 2026-10-24 v9s on wood also sagged the servo supply to 4.81 V with no adapter reset, so the hanging >= 6.0 V target is no longer a test of the reset cause
- **Training:** 1500 iterations, 4096 envs, 84 min, final action std 0.12
- **Scorecard:** 8/11; fails: Isaac speed 0.05-0.15, foot lift min @0.10, Isaac hard survival min
- **Config:** `git show df0e855:walk_rl/experiments/v9w_joint_speed.yaml`
