thakur-sachin/walking_trex_project/assets/robots/trex/meshes/right_ankle.stl

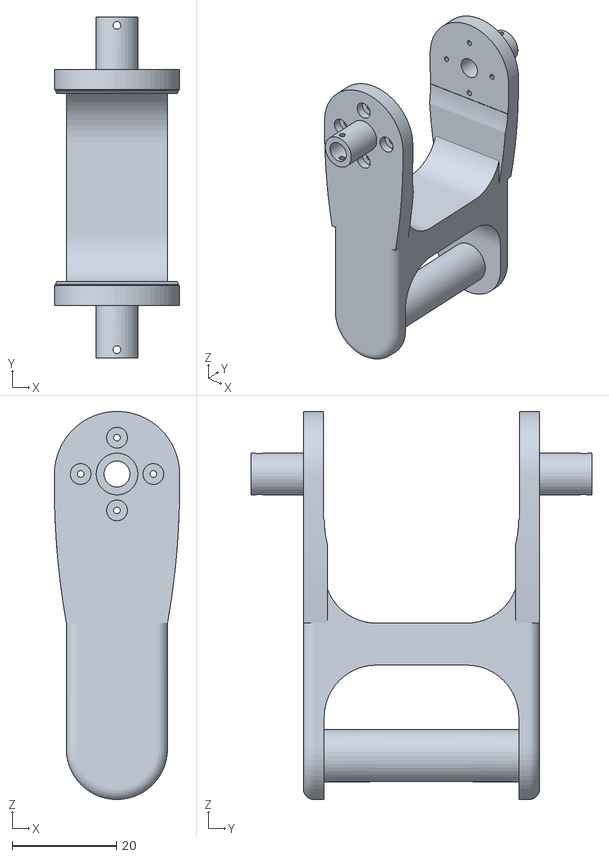
[picture p1: CAD file, 2026-10-29]
assets/robots/trex/meshes/right_ankle.stl
24.0 x 65.3 x 74.4
