thakur-sachin/walking_trex_project/walk_rl/walk_task.yaml

# Trex forward-walking RL task: everything tunable about the *task* (not the
# robot) lives here. Robot physical parameters (joint limits, servo torque,
# speed, resolution, mass) are read from assets/robots/trex/robot_config.yaml
# and must not be duplicated in this file.
#
# Task interface is grounded in what the real robot can sense and do:
#   actions     8 servo position targets (robot_config `actuated_joints`);
#               ankles are derived by the linkage (ankle = femur - tibia).
#   actor obs   BNO055 IMU (gravity direction, gyro) + 8 servo position
#               readings (quantized to the LX-16A's resolution) + own previous
#               action + velocity command + gait clock. NO base linear
#               velocity, NO joint velocity (finite-differenced from position
#               readings, as the Pi would), NO foot contact (no sensors).
#   critic obs  actor obs (noise-free) + privileged sim state (base velocity,
#               foot contacts/heights, servo torques). Used in training only.

sim:
  physics_hz: 200
  # Control rate. LX-16A bus budget at 115200 baud (10 bit/byte frames): one
  # position write per servo is 10 B (8 servos = 80 B = ~6.9 ms) and one
  # position read is 6 B request + 8 B reply (8 servos = 112 B = ~9.7 ms),
  # ~16.6 ms of pure wire time per cycle, i.e. ~60 Hz theoretical ceiling
  # before Pi-side Python/USB-serial latency. 25 Hz leaves ~2x margin; a
  # policy trained at 25 Hz can always be run on hardware that manages more,
  # the reverse is not true. Must divide physics_hz.
  control_hz: 25
  env_spacing_m: 1.0
  episode_length_s: 20.0
  spawn_height_m: 0.02 # same small clearance as scripts/test_load_robot.py
  ground_compliance: # PhysX compliant contact on the ground (walk_rl/ground.py); 0 = rigid, as v1-v8
    stiffness_n_per_m: 0.0
    damping_n_s_per_m: 0.0
  # Ground static = dynamic friction (walk_rl/ground.py); null = PhysX default 0.5. PhysX averages it
  # with the robot's (domain_randomization.friction_range), so effective = (ground + robot) / 2.
  ground_friction: null

command:
  # Forward velocity command (body-x, m/s). Hips are abduction joints (no hip
  # yaw) and the robot has no lateral/turning capability worth commanding
  # yet, so v1 is straight-line walking: vy and yaw-rate are penalized, not
  # commanded.
  vx_range_mps: [0.05, 0.25] # walking commands; 0 comes from standing_prob. v8: 0.25 so 0.20 is not the edge
  standing_prob: 0.2 # fraction of commands that are exactly 0 (stand still)
  slow_prob: 0.0 # v9d: fraction of walking commands drawn from slow_range_mps instead (0 = off)
  slow_range_mps: [0.03, 0.12]
  resample_time_s: 5.0

gait:
  # Phase clock: deployable (pure time), strongly regularizes bipedal gaits.
  use_phase_clock: true
  frequency_hz: 1.8
  # Speed-scaled clock (v8d experiment; 0 = fixed frequency, the default):
  # f = frequency_hz + frequency_per_mps * (cmd_vx - frequency_ref_mps), clamped to frequency_range_hz.
  frequency_per_mps: 0.0
  frequency_ref_mps: 0.10
  frequency_range_hz: [1.6, 2.4]
  stance_ratio: 0.6 # fraction of the cycle each foot is on the ground
  walking_cmd_threshold_mps: 0.03

actions:
  # target = default_pos + a * (scale_frac_of_limit * joint_limit), a in [-1,1]
  scale_frac_of_limit: 1.0
  # Per-joint action scale / observation normalization [deg] where it differs from robot_config's
  # symmetric joint limit (policy interface: saved with each run). {} = robot_config for all.
  joint_scale_deg: {}
  # Per-joint centre [deg] of the action and observation range: target = centre + a * scale,
  # obs = (q - centre) / scale (policy interface). {} = 0 for all.
  joint_center_deg: {}
  # true: scale and centre come from robot_config's physical range (joints.range_deg), so a in [-1, 1]
  # maps onto joint_lo..joint_hi and the goal is never clipped to the range (the coupled knee limit
  # and the servo speed ramp still apply). Overrides the two entries above. false before v9v.
  scale_to_range: false
  quantize_to_servo_resolution: true # commands are 0.24 deg steps on real servo
  # Servo-input low-pass: cmd = alpha*cmd_prev + (1-alpha)*action. 0 disables. At 25 Hz,
  # 0.5 -> ~4 Hz cutoff, ~1 control step of lag. Must be mirrored in the deployed loop.
  smoothing_alpha: 0.5
  # Serial-bus/driver latency, in control steps (40 ms each), sampled per episode.
  # v8: up to 2 (Open Duck uses 0-2 at 50 Hz); real LX-16A latency not measured yet.
  delay_steps_range: [0, 2]

actuator:
  # implicit_pd: PhysX/MuJoCo position drive (robot_config sim_drive gains) toward the ramped
  #   target, capped at stall torque (v1-v9b).
  # lx16a: explicit LX-16A torque model fitted to the real servos (walk_rl/actuator.py,
  #   robot_config actuator_model), drive gains 0, DR below in domain_randomization.actuator_model.
  model: implicit_pd

observation:
  noise: # sensor noise std (rough BNO055 / LX-16A estimates, flagged as such)
    gravity: 0.02 # ~1 deg orientation error
    gyro_rad_s: 0.05
    joint_pos_rad: 0.003 # on top of quantization
  # v8 (estimates, flagged): per-episode servo calibration offset on the READINGS (BD-X uses
  # +/-0.02 rad encoder offsets); IMU latency in control steps.
  encoder_offset_rad: 0.02
  imu_delay_steps_range: [0, 1]
  # per-episode IMU mount offset, uniform +-this (deg) in roll and pitch on gravity and gyro. The real
  # v9m walk read roll ~2 deg off the MuJoCo walk, and +-1-3 deg offsets moved v9m's MuJoCo speed
  # from 0 to 0.08 m/s at 0.10 (2026-10-20).
  imu_mount_offset_deg: 0.0
  # Stack of the last K actor frames (humanoid-gym 15, Open Duck 3 actions). Lets the policy
  # infer velocity and foot contact, which no sensor measures. Pi keeps the same ring buffer.
  history_len: 3
  heading:
    # Heading error to a reference yaw latched at the start of walking (BNO055 fused yaw;
    # Digit/BD-X observe heading the same way). Sachin approved this sensor-contract change.
    enabled: true
    ref_init_range_rad: 0.15 # start this far off the reference: correcting heading is part of the task
    drift_deg_per_min: 3.0 # BNO055 IMU-mode yaw drift, estimate (per-episode rate, +/-)
    noise_rad: 0.01
  scales:
    gyro: 0.25
    joint_vel: 0.05
    lin_vel: 2.0

termination:
  max_tilt_deg: 55.0
  min_head_height_m: 0.12 # head link z (standing ~0.216)
  # Only the feet may touch the ground. v4 learned to drag its tail as a third point of
  # balance; head/tail are there to *help balance*, not to be props. Any contact force above
  # the threshold on one of these links terminates the episode.
  ground_contact_links: [head, tail, base_link, left_femur, right_femur, left_tibia, right_tibia, left_ankle, right_ankle]
  ground_contact_force_n: 0.2

foot:
  # Privileged contact only (the real robot has no foot sensors; the actor never sees it).
  # From PhysX contact reports: a foot-link height threshold was wrong because the 4-bar
  # linkage keeps the feet parallel to the base, so body lean tilts them.
  contact_force_threshold_n: 1.0 # a foot carries ~6-7 N standing
  swing_clearance_target_m: 0.02 # height of the swing foot above the stance foot

reward:
  weights:
    track_vx: 3.0
    alive: 0.5
    upright: -4.0 # projected gravity xy squared
    lateral_vel: -2.0
    yaw_rate: -1.0
    track_yaw: 1.5 # exp(-wz^2/sigma^2); v1 circled ~100 deg/20 s without this
    action_accel: -0.05 # 2nd difference; NOTE -0.5 charged ~-3/step for exploration noise alone (v2 failed)
    ang_vel_xy: -0.05
    gait_contact: 2.0 # contact pattern matches phase clock
    swing_clearance: 2.0
    air_time: 6.0 # per touchdown: (swing duration - min) clipped to [0, max-min] seconds
    foot_slip: -1.0
    action_rate: -0.05
    torque: -0.02 # normalized by servo stall torque
    joint_limit: -2.0
    hip_deviation: -0.5
    body_contact: -5.0 # extra on top of terminated: tail/head/body on the ground
    terminated: -10.0
    # v8 terms (docs/PROJECT_HISTORY.md, v8 reward research); 0 or absent disables a term
    track_heading: 1.5 # Digit yaw-orientation tracking
    track_vx_lin: -2.0 # humanoid-gym track_vel_hard: |vx - cmd|, does not saturate
    base_acc: 0.5 # humanoid-gym/Digit: exp(-|dv|/sigma), smooth base
    base_rock: 0.5 # humanoid-gym vel_mismatch_exp (roll/pitch rate part)
    stand_still: -0.3 # Open Duck: mean |joint vel| when the command is 0
    torque_sat: -2.0 # sum relu(|tau|/stall - 0.8): LX-16A headroom
    feet_distance: -1.0 # humanoid-gym: lateral foot spacing within a band
    # v9 lateral terms (A2, docs/PROJECT_HISTORY.md); off here, on in experiments/v9*.yaml
    lateral_drift: 0.0 # Open Duck/Microduck: relu(|1 s EMA of v_y| - dead-band), heading frame
    roll_band: 0.0 # ToddlerBot: exp(-scale * relu(|roll| - band))
    foot_flat: 0.0 # stance feet: 1 - cos(sole tilt), summed over feet in contact
    # v9j posture terms; off here
    base_height: 0.0 # cm the base sits lower (relative to the lower foot) than in the spawn pose, beyond base_height_drop_m
    leg_symmetry: 0.0 # |1 s EMA of left - right| for femur and tibia, rad, summed
    joint_pose: 0.0 # sum over reward.joint_pose_joints of ((q - neutral) / joint scale)^2
    # v9w supply term; off here
    joint_speed: 0.0 # relu(weighted mean |joint vel| - joint_speed_deadband_rad_s): servo current on the shared 3 A supply
  track_vx_sigma: 0.06 # v8: 0.08 -> 0.06
  # Positive terms multiplied by clamp(v_x / cmd, 0, 1) while the command is non-zero (1 when it is
  # zero). [] = off. v9e-v9g: standing still kept the heading/yaw/roll/smoothness rewards and
  # earned 4.95/step against walking's 5.26, so pushes tipped training into standing.
  progress_gate: []
  # progress: clamp(v_x/cmd, 0, 1) (v9h walked at ~0.10-0.15 m/s whatever the command);
  # tracking: clamp(1 - |v_x/cmd - 1|, 0, 1), so walking faster than the command also loses
  progress_gate_mode: progress
  # v9d: sigma = clamp(rel * cmd, min, track_vx_sigma); 0 = fixed sigma. Standing at a 0.05 command
  # earns exp(-0.69) ~ 50% of track_vx with a fixed 0.06, ~0 with rel 0.3 / min 0.015.
  track_vx_sigma_rel: 0.0
  track_vx_sigma_min: 0.015
  gait_contact_mode: per_foot # per_foot: mean over feet (both planted = 60% while walking); both: all feet must match
  yaw_sigma_rad_s: 0.10
  air_time_min_s: 0.10
  air_time_max_s: 0.30
  joint_limit_margin: 0.9 # penalize beyond this fraction of the limit
  joint_limit_range_margin_deg: null # v9s: number = penalize the last N deg of the physical range_deg instead (sees asymmetric ends)
  heading_sigma_rad: 0.15
  base_acc_sigma_mps: 0.05 # per control step (40 ms)
  base_rock_sigma_rad_s: 1.0 # v7 rocked at |w_xy| ~1.4 rad/s
  torque_sat_frac: 0.8
  feet_lateral_band_frac: [0.7, 1.5] # x the spawn-pose lateral foot spacing
  lateral_drift_tau_s: 1.0 # EMA time constant: averages out the per-step sway
  lateral_drift_deadband_mps: 0.01 # v8d drifts ~0.05 m/s; target < 0.015 (0.3 m per 20 s)
  roll_band_rad: 0.10
  roll_band_scale: 100.0
  base_height_drop_m: 0.03 # relative to the feet, v9c-v9i walk 28-37 mm below the spawn pose
  leg_symmetry_tau_s: 1.0
  joint_pose_joints: [head_joint, tail_joint]
  joint_speed_deadband_rad_s: 0.7 # 40 deg/s; v9s walked at 48 deg/s mean on the real robot, v9v at 88
  joint_speed_joint_weights: {} # joint name -> weight in the mean (default 1)
  # foot_slip measured at the foot link origin (moves when the foot rotates) or at the sole centre.
  # v9k replay: 60 % of Isaac's progress was the soles sliding forward while touching the floor.
  foot_slip_point: origin

harness:
  # Training-only curriculum. v6 (tail forbidden) stood still for 200+ iterations: foot air
  # time stayed 0.000 because lifting a foot unaided is an exploration barrier. The harness
  # holds the body up and level so stepping is safe to discover; its strength is annealed
  # to 0, so the final policy balances unassisted (evaluate with the harness OFF).
  enabled: true
  weight_fraction: 0.7 # upward force on the base, fraction of total body weight (at alpha=1)
  torque_kp: 3.0 # N*m per rad of roll/pitch error (righting torque)
  torque_kd: 0.15 # N*m per rad/s
  start_iter: 150 # alpha = 1 until here
  end_iter: 450 # then linear to 0

push:
  # Training-only disturbances: instantaneous base-velocity changes (BD-X, Open Duck,
  # humanoid-gym). Ramped in after the harness is gone: scale 0 until start_iter, 1 at end_iter.
  enabled: true
  start_iter: 500
  end_iter: 800
  interval_s: [4.0, 8.0]
  max_lin_vel_mps: 0.25 # xy, at scale 1 (robot walks at <=0.25 m/s)
  max_ang_vel_rad_s: 0.5

domain_randomization:
  # Only with actuator.model: lx16a (replaces pd_gain_scale_range / torque_cap_scale_range).
  # Ranges span the four fits and leave room: the loaded bench test (B4) should narrow them.
  actuator_model:
    kp_scale_range: [0.75, 1.3] # 9.2-15.9 duty/rad (fits 10.3-15.2)
    deadband_deg_range: [0.1, 1.0] # fits 0.29-0.54
    latency_s_range: [0.0, 0.01] # fits 1.4-4.1 ms; plus actions.delay_steps_range on top
    armature_scale_range: [0.6, 1.6] # 0.013-0.034 kg m^2 (fits 0.014-0.021)
    coulomb_friction_nm_range: [0.1, 0.55] # fits 0.15-0.49
    no_load_speed_scale_range: [0.38, 0.65] # x datasheet (fits 0.44-0.57)
    stall_torque_scale_range: [0.75, 1.05] # x datasheet, not identified yet
    bus_voltage_v_range: [6.6, 8.4] # 2S pack, unmeasured under load (B7); rest 7.06-7.16 V seen
  enabled: true
  friction_range: [0.4, 1.2]
  # v8 tried [0.7, 1.5]: under the harness, envs above x1.1 fell 4-7x more often (servos cannot
  # hold a heavier base up; v7 notes tibia saturation at 1.0 kg). Kept at v7 range until the real
  # mass is known -- a heavy real base_link is a hardware problem, not a policy one.
  base_mass_scale_range: [0.8, 1.3]
  limb_mass_scale_range: [0.85, 1.15] # head, tail
  base_com_offset_m: 0.015 # battery/Pi placement not measured
  pd_gain_scale_range: [0.85, 1.15]
  torque_cap_scale_range: [0.85, 1.0] # servos weaker than datasheet, never stronger
  reset_joint_noise_rad: 0.05
  reset_tilt_noise_rad: 0.03

ppo:
  num_envs: 4096
  rollout_steps: 24
  epochs: 5
  minibatches: 4
  gamma: 0.99
  lam: 0.95
  clip: 0.2
  value_coef: 1.0
  entropy_coef: 0.005
  max_action_std: null # optional ceiling on the policy's action std (v9 configs: 0.5)
  lr: 5.0e-4 # v3 at 1e-3 collapsed at ~it 750 (single-update KL 0.24); minibatch KL guard added
  lr_decay_to: 1.0e-4 # linear decay across each train.py call
  desired_kl: 0.02 # KL guard: stop updating at 2x this per minibatch, 1.5x per epoch
  max_grad_norm: 1.0
  init_log_std: -1.0
  actor_hidden: [128, 128, 64] # small: must fit a Pi 4 CPU control loop
  critic_hidden: [256, 128, 64]
  # v9: left/right symmetry (walk_rl/symmetry.py; map verified by walk_rl/test_symmetry.py --sim).
  # v8d limps (left steps +4.3 cm, right -0.4 cm) and crabs ~1 m/20 s sideways although the CAD
  # is symmetric to ~3 mm, so the asymmetry is learned. Off by default: switched on per experiment.
  symmetry:
    augment: false # add the mirrored copy of every sample to each minibatch
    mirror_loss_coef: 0.0 # > 0: |mu(mirror o) - mirror mu(o)|^2
